StarryClear/LQR_Furuta/VERSION_1.1.md

# VERSION_1.1 · 平衡抖动修复（2026-11-03）

## 一、改了什么

只动 `src/lqr_core.v` 两个常数：

| 项 | 1.0（0x6A6F） | 1.1（0x2D55） |
|---|---|---|
| `KDT`（θ̇ 阻尼，Q8） | 60 | **120** |
| θ̇ 一阶低通 | `>>>3`（8 ms） | **`>>>1`（2 ms）** |

原因：1.0 的 8 ms 低通在 5 Hz 吃 14°、11.4 Hz 吃 33°，把 KDT 的相位超前吃光；KDT 本身又只有设计值的 1/7。结果是 5 Hz、±3° 的极限环。加 KDT、缩低通后 5 Hz 动能从 96% 降到约 3%。

## 二、码流与复验

- 码流：`firmware/LQR_end1.1_0x2D55.fs`，**CheckSum 0x2D55**
- 源码重建校验和 **0x2D55**（与板上逐字节等价，见 `evidence/build_1.1.log`）
- Fmax **50.022 MHz**（约束 50.000）、TNS setup/hold **0/0**、最差 setup slack **+0.009 ns**
- CLS 7550/10368（73%）、DSP 11/24（46%）

重建：

```powershell
cd <仓库根目录>
& '$env:GOWIN_HOME\IDE\bin\gw_sh.exe' build.tcl
```

## 三、实测效果

### 3.1 定版十段实测（2026-11-03 20:20~21:10，板载本版 1.1）

全部原始数据 `docs/data/v30_S*.csv`，每段单独抓包，判据口径见 `docs/03_数据与复算.md`。

| 段 | 内容 | 结果 |
|---|---|---|
| S0 / S0b2 | 连通与静止噪声 | 100.1 Hz 稳定；SA100 静止 ±0.25°（1σ 0.06°，60 s 内 6 个码值） |
| S1 | 起摆单次 | 6.76 s 起 kick、**7.91 s 进平衡**，此后连续 22.1 s |
| S2 | 起摆统计 | **10/10 成功**（11 轮里 1 轮起点过晚剔除），中位 **1.14 s**（1.11~1.16） |
| S3 | 平衡预热 90 s | p50 0.70° / p95 1.80° / rms 0.93° / max 2.70°，主频 **8.22 Hz** |
| S4 | **长跑 660.1 s** | p50 **0.70°** / p95 **1.60°** / rms **0.86°** / max 2.40°；duty 峰值 1161、**饱和 0 帧**；横臂净漂 −21 counts（−9.2°，**0.83 °/min**）；主频 8.03 Hz |
| S6 | 抗瞬时推扰 60 s | 峰值 5.0~14.1°，**8 次推扰 8 次恢复**，恢复 0.19~1.33 s |
| S7b | 跟随阶跃 +18° | 实测 +14.4°、静差 −3.6°、过冲 26° 后回落；θ p50 0.70° / p95 1.60°，与纯平衡同 |
| S9 | 正弦 0.245 Hz / 35° | 实测 ±26.6°（**76%**），θ p95 1.90° |
| S10 | 正弦 0.351 Hz / 50° | 实测 ±33.8°（**68%**），θ p95 3.10° |

两条判废记录（不进任何报告/文档结论）：`v30_S5_discarded.csv`（抓包早于指令，两次推倒）、
`v30_S7.csv`（手碰台面导致掉摆，非跟随所致）。

### 3.2 短测（111 s）与 1.0 的对比

数据：`docs/data/hold_1.1_111s.csv`（111.0 s 连续平衡，截止到第一次掉摆前；统计去掉前 3 s 捕获瞬态）。

| 指标 | 1.0（514.8 s 段） | 1.1（111 s 段） | 1.1（定版 660 s 段） |
|---|---|---|---|
| \|θ\| p50 | 1.70° | **0.70°** | 0.70° |
| \|θ\| p95 | 3.50° | **1.80°** | **1.60°** |
| rms | 2.03° | **≈0.9°** | 0.86° |
| 主频 | 5.1 Hz | **8.1 Hz** | 8.03 Hz |
| 3–7 Hz 能量 | 96% | **0.12°（≈3%）** | — |
| 7–10 Hz | 0.1° | 0.76° | — |
| duty 翻转 | 10.1 次/s | 18.4 次/s | — |
| duty 峰值 | 1850 | 955 | 1161 |

## 四、为什么 8.1 Hz 不再继续压

8.1 Hz 是**结构模态**：同频下编码器只有 0.12°，摆杆 1.0°——电机侧和横臂侧不同步（联轴器/横臂扭转）。

试过 8.4 Hz 二阶陷波：

| 版本 | 主频 | p95 | rms |
|---|---|---|---|
| 陷波 Q=6（0x9CDE） | 6.0 Hz | 2.40° | 1.30° |
| 陷波 Q=10（0xA6F6） | 5.85 Hz | 2.30° | 1.22° |

8.4 Hz 确实压到 0.1° 量级，但**刚体模态（横臂跟着动）顶到 5.85–6.0 Hz，幅值更大**。结论：陷波得不偿失，回退到无陷波。两个陷波码流留在原 `LQR_end/firmware/`。

根治只能靠机械：刚性联轴器、横臂加筋，把结构模态推到 15 Hz 以上。

## 五、回滚

```powershell
& '$env:GOWIN_HOME\Programmer\bin\programmer_cli.exe' `
    --device GW2A-18C --cable "Gowin USB Cable(FT2CH)" --run 2 `
    --fsFile "<仓库根目录>\firmware\history\LQR_end_1.0_0x6A6F.fs"
```

## 六、未决与注意

1. **240 s 记录里的跑飞**（2026-11-03 15:0x）：120 s 后横臂持续单向跑、三次掉摆。11-03 晚的
   十段实测里，纯平衡 **660.1 s 未再复现**（S4），单格跟随也正常（S7b），因此判断那次是
   **进了跟随/正弦且目标连续变化**时的老问题，不是平衡通路的退化；但**机理仍未定位**
   （遥测没有 `phi_tgt` 通道，见 `docs/04_已知问题.md` A-1）。
2. **起摆/抗扰已在 1.1 上重测**：起摆 10/10、抗扰 8/8（见第三节）。1.0 的 83% 与 33/35 是
   历史数据，写报告时两者不要混用。
3. **SA100 滑环死点**：每次重烧后若 `ch0` 的 bit7=1、θ 冻结，手转横臂半圈即可（老问题，未修）。
   11-03 晚 S0b 首测的 θ=−116.9° 冻结即此现象，手拨后恢复（S0b2 通过）。
