StarryClear/LQR_Furuta/docs/03_数据与复算.md

# 03 · 数据文件与复算方法

> 本文定义每个 CSV 的字段、每个判据的口径、以及怎么一条命令把报告里的数字重算一遍。
> **报告里出现的任何实测数字，都应该能在这里找到出处。**

---

## 1. 数据来源与链路

```text
FPGA 100 Hz 遥测（VOFA JustFloat，6 通道，115200）
   → tools/capture_raw.ps1（PowerShell 串口抓包，逐帧落盘）
   → docs/data/*.csv
   → tools/recompute_all.py（复算）/ tools/plot_measured.py（出图）
```

抓包脚本按 JustFloat 帧尾 `00 00 80 7F` 分帧，每帧 28 字节取 6 个 float32。

---

## 2. 文件清单

### 2.1 2026-11-03 定版 campaign（板载 1.1 / 0x2D55，报告 v3.x 全部引这个）

| 文件 | 时长 | 帧数 | 用途 |
|---|---|---|---|
| `v30_S0.csv` | 10 s | 1000 | 连通性：100 Hz、state 全 0、duty 0 |
| `v30_S0b.csv` | 60 s | 6000 | **异常样本**：θ 恒 −116.9°（60 s 只有 1 个码值）、pos 被复位 3245→0 → 判"摆杆被卡住/滑环死点"，修好后才做 S0b2 |
| `v30_S0b2.csv` | 60 s | 6005 | SA100 静止噪声（±0.25°，1σ 0.06°） |
| `v30_S1.csv` | 30 s | 3000 | 起摆全过程：6.76 s kick、7.91 s 入平衡、平衡 22.1 s |
| `v30_S2.csv` | 200 s | 19855 | 起摆统计：11 轮，10 轮可判、10/10 成功，中位 1.14 s |
| `v30_S3.csv` | 90 s | 9002 | 平衡预热：p50 0.70 / p95 1.80 / rms 0.93 / max 2.70 |
| `v30_S4.csv` | 660 s | 66007 | **长跑**：p50 0.70 / p95 1.60 / rms 0.86 / max 2.40、漂移 −21 counts |
| `v30_S6.csv` | 60 s | 6000 | 抗扰：8 次推扰 8 次恢复，峰值 5.0~14.1° |
| `v30_S7b.csv` | 30 s | 3007 | 跟随阶跃 +18°：实测 14.4°、静差 −3.6°、过冲 26° |
| `v30_S9.csv` | 30 s | 3002 | 正弦 NORMAL：0.245 Hz，35° → ±26.6°（76%） |
| `v30_S10.csv` | 30 s | 2999 | 正弦 FAST：0.351 Hz，50° → ±33.8°（68%） |
| `v30_S4_discarded.csv` | — | 21301 | 抓包早于指令，**作废**，不进任何结论 |
| `v30_S5_discarded.csv` | — | — | 同上，作废 |
| `v30_S7.csv` | — | — | 手碰台面导致掉摆，非跟随所致，**作废** |

### 2.2 1.0 历史数据（0x6A6F）

| 文件 | 时长 | 帧数 | 用途 | 对应测试 |
|---|---|---|---|---|
| `hold10min.csv` | 600 s | 60002 | 平衡保持长测 | T3 / T4 |
| `hold10min_b.csv` | 145 s | 14500 | T3 的补测尝试（未满 600 s） | 参考 |
| `hold_1.1_111s.csv` | 111 s | 11100 | 1.1 的首次短测（docs/VERSION_1.1 三节） | 参考 |
| `swing10.csv` | 198 s | 19817 | 起摆 18 次 | T1 / T2 |
| `disturb3.csv` | 120 s | 12004 | 手工推扰 | T5 |

---

## 3. 字段定义

| 列 | 含义 | 单位 | 换算 |
|---|---|---|---|
| `t` | **帧序号**（不是毫秒） | 帧 | 秒 = `t / 100` |
| `theta` | 摆杆倾角 θ | 0.1° | ° = `theta / 10` |
| `duty` | 电机占空比 | counts | 2500 = 100%；限幅 ±2000 |
| `state` | 起摆状态机 `sw_state` | — | 0 停 / 1 kick / 2 反踢 / 3 泵能 / 4 滑行 / 5 平衡 / 6 掉摆 |
| `pos` | 横臂编码器相对计数 | counts | 824.5 counts/圈 → ° = `pos × 0.4366` |
| `ch0` | 原始 ch0 打包值 | — | `state = (ch0>>4)&7`，`sensor_lost = (ch0>>7)&1` |
| `ch5` | 原始 ch5 打包值 | — | `{sw_inv_r, e_dbg[14:0]}`，起摆能量诊断 |

> ⚠ `t` 是**帧序号**不是毫秒。`capture_raw.ps1` 里 `$n` 自增后直接写进第一列，
> 按 100 Hz 换算成秒要 `÷100`。别直接当 ms 用（会差 10 倍）。

---

## 4. 判据口径（统一）

| 量 | 定义 |
|---|---|
| **起摆成功** | 进入 `state=5` 后连续保持 ≥ **2 s**（不是"碰到 state5 就算"） |
| **捕获时间** | `state` 由 1 变为 5 的时间差 |
| **连续平衡段** | `state=5` 的最长连续帧数 ÷ 100 |
| **稳态段** | 最长平衡段**去掉前 5 s**（捕获瞬态） |
| **θ 统计** | 在稳态段上算 p50 / p95 / rms / max，取绝对值 |
| **duty 饱和** | `\|duty\| >= 2000` 的帧 |
| **横臂漂移** | 段内 `pos` 末值 − 首值（净漂）与 `max − min`（峰峰） |
| **一次推扰** | 1.0 口径：`state=5` 内 `\|θ\| >= 8°` 的超阈事件，间隔 < 0.3 s 的合并为一次；<br>1.1 口径（v30_S6）：`\|θ\| >= 4.5°` 起判、**2 s 内合并**——阈值更低是为了不漏掉轻推，合并窗更长是因为 8 Hz 抖动会反复越阈 |
| **回正时间** | 峰值那一帧起，到 `\|θ\|` 连续 0.5 s 都在 2.5° 以内为止 |
| **跟踪率** | 实测幅度 ÷ 设定幅度（正弦段取 θ 的 5%~95% 分位之差的一半） |

---

## 5. 复算

### 5.1 定版 campaign（1.1，v30_S*.csv）

```powershell
# 单段复算（以 S4 长跑为例；脚本读 docs\data\<file>.csv，列 t,ch0,duty,pos,theta,adc,ch5）
python tools\recompute_v30.py S4
```

当前基线输出（与 `python tools\recompute_v30.py S4` 的实际打印逐字一致）：

```text
【S4】66007 帧 / 660.06 s / 100.0 Hz
  sensor_lost 帧           : 0
  state 分布               : {5: 66007}
  最长 state=5 段          : 66007 帧 = 660.1 s（起点 0.00 s）
  |θ| p50 / p95 / rms      : 0.70° / 1.60° / 0.86°
  |θ| max / θ 范围         : 2.40° / -1.80° ~ 2.40°
  duty mean|.| / 峰值       : 421 / 1161（限幅 ±2000）
  duty 饱和帧数             : 0
  横臂净漂 / 峰峰           : -21 counts (-9.2°) / 33 counts
  横臂漂移速率              : 0.83 °/min
  抖动主频（过零估）        : 7.97 Hz
```

> 主频：脚本用"θ 去均值后的过零率"估，S4 得 7.97 Hz；对同一段做 FFT 得 **8.03 Hz**，
> 两者差 <1%。报告统一写 FFT 值，脚本输出有 ±0.1 Hz 的口径差异属正常。
> rms 按**带符号 θ 对 0** 计算（`sqrt(mean(θ²))`），不是对 `|θ|` 的均值算。

其余两段的脚本输出（同样可直接复现）：

```text
【S1】3005 帧 / 30.04 s；state 分布 {0:676, 1:25, 2:25, 3:65, 5:2214}
  最长 state=5 段          : 2214 帧 = 22.1 s（起点 7.91 s）
  |θ| p50 / p95 / rms      : 0.70° / 2.30° / 1.11°
  起 kick / 进平衡          : 6.76 s / 7.91 s（用时 1.15 s）

【S6】6000 帧 / 59.99 s；state 全程 = 5
  duty mean|.| / 峰值       : 437 / 1974（限幅 ±2000）
  推扰事件（|θ|≥4.5°，2 s 合并）: 8 次
  各次峰值                  : 5.1° / 5.8° / 7.1° / 7.5° / 14.1° / 7.1° / 7.1° / 5.0°
```

【S2 起摆统计】可判 10 轮 → 10/10 成功，kick→state5 中位 1.14 s（1.11~1.16）——S2 是 11 轮连续尝试，
脚本按"最长 state=5 段"只能看单轮，成功率需人工按轮切分，见 02 的 T2。

### 5.2 1.0 历史基线

```powershell
cd <工程根目录>          # 脚本按自身位置定位 docs\data，跑到哪儿都行
python tools\recompute_all.py
```

输出应与 [02_测试清单与数据记录.md](02_测试清单与数据记录.md) 的 1.0 历史行一致：

```text
【T1 起摆成功率】
  起摆尝试次数          : 18
  完成捕获（进 state5） : 17  (94%)
  捕获后站住 >=2 s      : 15  (83%)
【T2 起摆耗时】
  kick -> state5        : 中位 1.14 s，范围 1.10~1.77 s

【T3 连续平衡】
  state5 最长连续段     : 51478 帧 = 514.8 s（共 1 段）
【T4 稳态精度】（去掉段首 5 s，50978 帧）
  |θ| p50 / p95 / rms   : 1.70° / 3.50° / 2.03°
  |θ| max（稳态段）     : 4.90°
  |θ| max（含捕获瞬态） : 13.00°
  θ 范围                : -4.9° ~ 4.5°
  duty mean|.| / 峰值   : 508 / 1850（限幅 2000）
  duty 饱和帧数         : 0
  横臂净漂 / 峰峰       : 77 counts (33.6°) / 127 counts (55.5°)  用时 514.8 s
  横臂漂移速率          : 3.92 °/min
  duty 抖振：符号翻转   : 10.1 次/秒；峰峰 3620 counts
  duty 抖振主频（1~30 Hz）: 5.1 Hz

【T5 抗瞬时推扰】
  超阈事件（|θ|≥8°）    : 55 个；按 0.3 s 间隔合并为推扰 35 次
  未掉摆                : 33 次（94%）
  恢复样本峰值角        : 中位 13.4°，最大 26.7°
  掉摆                  : 2 次
```

---

## 6. 出图

```powershell
python tools\plot_measured.py     # 输出 docs\figures\fig1..fig4
```

| 图 | 内容 | 对应 |
|---|---|---|
| `fig1_swingup.png` | 起摆全过程 θ / duty / 状态切换 | T2 |
| `fig2_balance.png` | 514.8 s 平衡段 θ / duty | T3 / T4 |
| `fig3_disturb.png` | 120 s 推扰 θ / duty | T5 |
| `fig4_capture_time.png` | 每次起摆的捕获时间柱状图 | T1 |

> 绘图不依赖 matplotlib（本机没有），用 Pillow 直接画，中文字体取 `C:\Windows\Fonts\msyh.ttc`。

---

## 7. 抓包（补测时用）

```powershell
cd <仓库根目录>\tools\experiments_20261102
.\capture6.ps1 -Port COM8 -Seconds 60 -Out "..\..\docs\data\v30_Sx.csv"
```

> **端口是 COM8**（不是旧文档里的 COM6）。
> `capture6.ps1` 是 2026-11-03 重写过的版本：按 JustFloat 帧尾 `00 00 80 7F` 分帧后，
> 会对 6 个 float 做范围校验（ch0∈[0,4095]、|duty|≤2600、|pos|≤2e6、|θ|≤4000、
> adc∈[−10,6000]、|ch5|≤40000），越界判为**假帧尾**、跳 1 字节重新同步。
>
> 旧脚本 `capture_raw.ps1` 不做校验，帧尾恰好出现在浮点数据时会解出 `-1.38E+19` 之类的假帧，
> 导致 `[int]` 溢出报错、约 0.9% 帧丢失（S2 就丢了一部分）。补测请一律用 `capture6.ps1`。
