StarryClear/LQR_Furuta/docs/figures/fig1_swingup.png

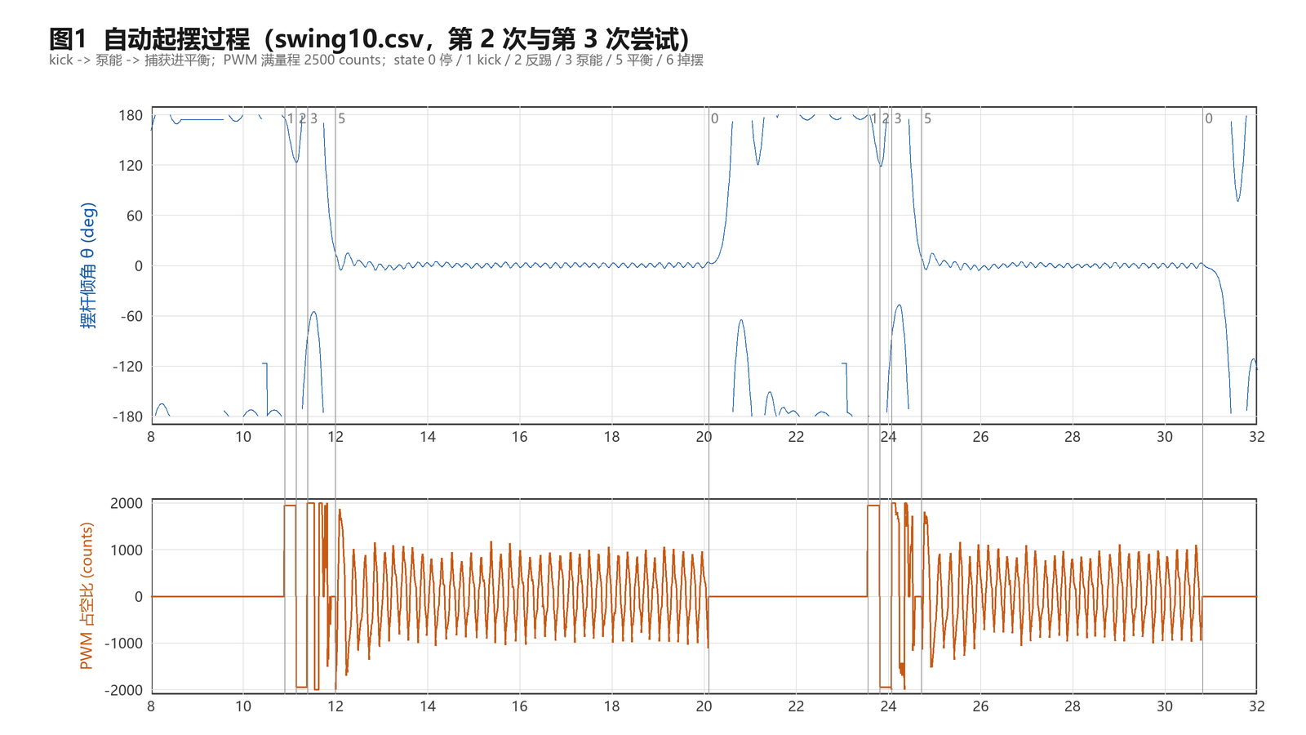
docs/figures/fig1_swingup.png
