StarryClear/LQR_Furuta/docs/figures/fig3_disturb.png

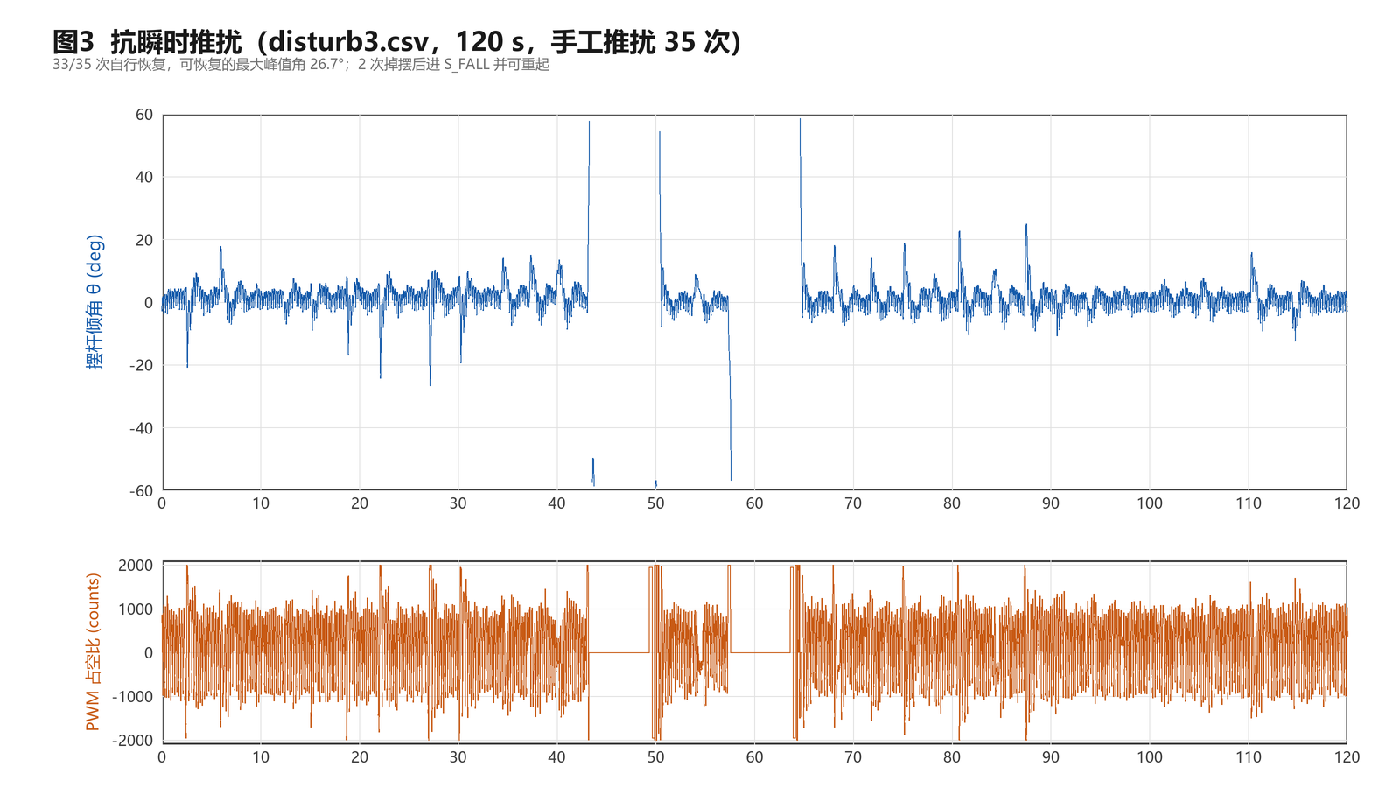
docs/figures/fig3_disturb.png
