StarryClear/LQR_Furuta/docs/figures/fig4_capture_time.png

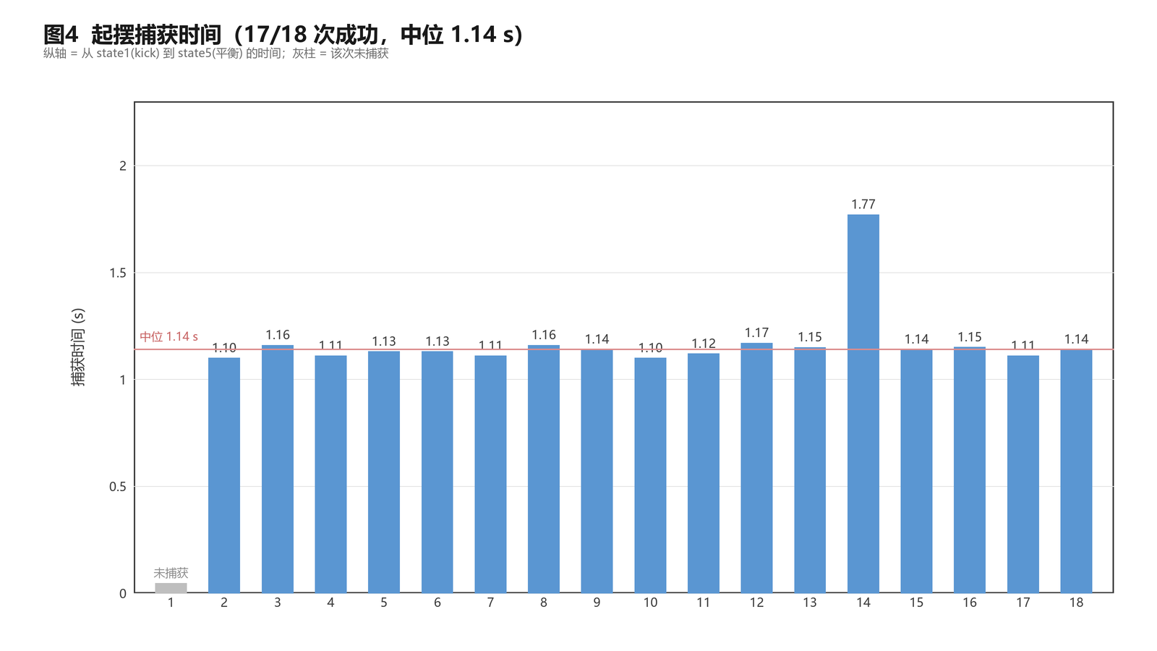
docs/figures/fig4_capture_time.png
