StarryClear/LQR_Furuta/docs/02_测试清单与数据记录.md

# 02 · 测试清单与数据记录（LQR_end 定版）

> 逐项测量 → 就地记录 → 报告直接引用。每项写明**测法、判据、原始数据文件、复算命令**。
> 所有数字都能复算：1.0 基线用 `python tools/recompute_all.py`，定版 campaign 用
> `python tools/recompute_v30.py all`；对不上就是文档与数据脱节了。
>
> 数据目录：`docs/data/`　图：`docs/figures/`　证据：`evidence/`

---

## 0. 记录约定

| 符号 | 含义 |
|---|---|
| ✅ | 已测，数据在 `docs/data/` |
| ⬜ | 未测 |
| 🅿️ | 只是静态参数，从综合报告读出 |
| 判据 | 赛题原文要求 或 工程自定目标 |

**统一口径**：遥测 100 Hz；θ 单位 0.1°（记录时换 °）；duty 单位 counts（2500 = 100%）；pos 单位编码器计数（824.5 counts/圈 ≈ 0.4366°/count）。

---

## 1. 赛题要求对照总表

| 赛题条目 | 要求 | 本工程状态（2026-11-03 定版实测） | 判定 |
|---|---|---|---|
| 基础 ① | 起摆：静止下垂的摆杆被抬起，最终停在垂直位置附近 | **10/10 成功**，kick→平衡 中位 1.14 s（`v30_S2`） | ✅ |
| 基础 ② | 自平衡：长时间稳定保持在垂直平衡位置 | 单段 **660.1 s** 不倒（`v30_S4`） | ✅ |
| 基础 ③ | 平衡后无明显震荡；能抗轻微外力并短时间恢复 | \|θ\| p95 **1.60°**；推扰 **8/8 恢复**，可恢复峰值 14.1°（`v30_S4`/`v30_S6`） | ✅ |
| 拓展 ① | 键盘/拨码设定目标位置，电机平滑移动并保持静止 | 旋钮 + OLED，每格 18°；**实测 +18° → +14.4°，静差 −3.6°**（`v30_S7b`） | ✅ |
| 拓展 ② | 电机按特定速度曲线/轨迹运动，同时保持摆杆不倒 | 正弦 **0.245 Hz 跟踪 76% / 0.351 Hz 68%**，全程不倒（`v30_S9`/`v30_S10`） | ✅ |
| 拓展 ③ | 位置控制过程中摆杆始终直立 | 单格阶跃能保持直立；**大目标阶跃仍会掉摆**（未实测阈值已写入 04） | ⚠ |

> 拓展①②已有实测；拓展③只测到"单格 18° 不掉"，更大阶跃没有再测（会掉，见 04 已知问题 A-1）。

---

## 2. 基础要求

### T1 起摆成功率 ✅

- **测法**：F10 复位 → 等 1 s → 按 D11，重复 N 次；判"成功"为捕获后站住 ≥ 2 s
- **判据**：成功率 ≥ 90%
- **数据**：`docs/data/v30_S2.csv`（1.1 定版，200 s）、`docs/data/swing10.csv`（1.0，198 s）
- **实测（1.1，2026-11-03）**：

| 指标 | 数值 |
|---|---|
| 起摆尝试 | **11** 轮（第 11 轮起点过晚、数据不足，剔除） |
| 可判轮数 | 10 |
| **捕获后站住 ≥2 s** | **10 / 10 = 100%** |
| 捕获时间 | 中位 **1.14 s**，范围 1.11 ~ 1.16 s |

- **1.0 历史**：18 次尝试、17 次捕获（94%）、15 次站住（83%）；3 次失败均伴随 SA100 坏点。
- **图**：[fig4_capture_time.png](figures/fig4_capture_time.png)（1.0 数据）

### T2 起摆时间分解 ✅

- **判据**：起摆全过程 ≤ 3 s
- **实测**（读 state 机时间戳）：

| 阶段 | 耗时 |
|---|---|
| kick（state 1） | ≈ 250 ms |
| 反踢（state 2） | ≈ 250 ms |
| 泵能（state 3） | ≈ 550 ms |
| **kick → 捕获（state 5）** | **1.14 s（中位）** |

- **1.1 单次全过程**（`docs/data/v30_S1.csv`）：0 s 静止 → **6.76 s** 起 kick → 7.01 / 7.26 s 过 state 2/3
  → **7.91 s 进 state 5** → 此后连续平衡 22.1 s（到 30 s 抓包结束）。
- **结论**：远优于 3 s 判据；10 次成功样本全部落在 1.11~1.16 s，重复性很好。
- **图**：[fig1_swingup.png](figures/fig1_swingup.png)（1.0 数据）

### T3 平衡保持时长 ✅

- **测法**：起摆入稳后不接触，连续抓包 660 s，统计 `state=5` 的最长连续段
- **判据**：≥ 10 分钟（600 s）
- **数据**：`docs/data/v30_S4.csv`（660.07 s，66007 帧，20:38:54~20:49:54）
- **实测**：

| 指标 | 数值 |
|---|---|
| 最长连续平衡段 | **66007 帧 = 660.1 s**（11 分 00 秒） |
| 闭环段数 | 1 段（全程 state=5，无掉摆、无重摆） |
| 口径说明 | 抓包起点已在平衡态，故结论写作"**连续平衡 ≥ 660 s**"，不是"从起摆算起 660 s" |
| 1.0 历史 | 514.8 s（抓包比起摆早开约 85 s，故未满 600 s） |

### T4 平衡稳态精度 ✅

- **测法**：取 T3 最长闭环段全程统计（1.1 段首已在平衡态，无捕获瞬态需剔除）
- **判据**：\|θ\| p95 ≤ 3°；横臂漂移 ≤ ±15°
- **实测**（66007 帧）：

| 指标 | 1.1（660.1 s） | 1.0（514.8 s，历史） |
|---|---|---|
| \|θ\| p50 | **0.70°** | 1.70° |
| \|θ\| p95 | **1.60°** | 3.50° |
| \|θ\| rms | 0.86° | 2.03° |
| \|θ\| max | **2.40°**（范围 −1.80° ~ +2.40°） | 4.90°（含瞬态 13.0°） |
| duty mean\|.\| | 421（满量程 2500 的 17%） | 508 |
| duty 峰值 | **1161**（限幅 2000） | 1850 |
| **duty 饱和帧数** | **0** | 0 |
| 横臂净漂 | **−21 counts / −9.2°** | 77 counts / 33.6° |
| 横臂峰峰 | 33 counts | 127 counts |
| 横臂漂移速率 | **0.83 °/min** | 3.92 °/min |
| 抖动主频 | 8.03 Hz | 5.1 Hz |

- **结论**：θ 指标满足判据；横臂漂移由 3.9 °/min 降到 **0.83 °/min**（外环积分起效），11 分钟漂 9.2°，
  仍在"±15°"口径内。属外环无位置反馈的固有慢漂。
- **图**：[fig2_balance.png](figures/fig2_balance.png)（1.0 数据）

### T5 抗瞬时推扰 ✅

- **测法**：平衡中手工瞬时推扰，抓包 60 s
- **数据**：`docs/data/v30_S6.csv`（1.1 定版，60 s）、`docs/data/disturb3.csv`（1.0，120 s）
- **判据**：轻微/中等推扰能恢复且不倒
- **实测（1.1，复算口径：state5 内 \|θ\|≥4.5° 起判，2 s 内合并为一次推扰）**：

| 指标 | 数值 |
|---|---|
| 检出推扰 | **8** 次 |
| 未掉摆（恢复） | **8 次（100%）** |
| 各次峰值角 | 5.1° / 5.8° / 7.1° / 7.5° / **14.1°** / 7.1° / 7.1° / 5.0° |
| 恢复时间 | 0.19 ~ 1.33 s（回到 ±5° 内） |
| 单次推扰 duty 峰值 | 1974（99% 限幅），全程饱和 0 帧 |
| 横臂位移 | 净 −10 counts，峰峰 218 counts（≈95°，无位置环不自回） |

- **1.0 历史**：120 s 内 35 次推扰、33 次恢复（94%），可恢复峰值 26.7°。
- **说明（报告必须保留）**：推扰由人手施加，**力度不可标定**，因此以"实测摆杆峰值角"作为强度度量，
  而不是标称力/角度。
- **图**：[fig3_disturb.png](figures/fig3_disturb.png)（1.0 数据）

---

## 3. 拓展要求（当前空白）

> 这三项是赛题拓展分，**固件已经能跑，缺的只是抓包**。每项约 20~30 分钟。

### T6 跟随定位精度 ✅（单格已实测）

- **测法**：平衡后进轨迹页选"跟随"，旋钮转过一格（每格 18°），记录实际位移与收敛过程
- **判据**：单格位移误差 ≤ 3°；无明显持续振荡
- **数据**：`docs/data/v30_S7b.csv`（30.06 s，全程 state=5）
- **实测（FAST 档，目标 +18°）**：

| 指标 | 数值 |
|---|---|
| 目标角 | +18° |
| 稳态实测 | **+14.4°**（+33 counts） |
| 稳态误差 | **−3.6°** |
| 过程过冲 | 26°（59 counts），随后回落 |
| 收敛 | 约 1 s 内稳住 |
| 摆杆 \|θ\| p50 / p95 | 0.70° / **1.60°**（与纯平衡同，跟随未牺牲姿态） |
| duty 饱和 | 0 帧 |

- **结论**：单格阶跃能站住，但**静差 3.6° 超出 3° 判据**——外环无积分作用于 φ 目标（积分作用在绝对 θ），
  属结构性问题，见 [04_已知问题.md](04_已知问题.md) B-2。
- **未测**：其余三档速度、连续多格（3 格 = 54°）—— 大目标阶跃会掉摆，先不写进结论。

### T7 正弦轨迹 ✅（两档已实测）

- **测法**：轨迹页选正弦档，速度档选 NORMAL / FAST，各跑 30 s
- **判据**：摆杆 \|θ\| p95 ≤ 8°、不倒下
- **数据**：`docs/data/v30_S9.csv`（NORMAL）、`docs/data/v30_S10.csv`（FAST）
- **实测**：

| 速度档 | 频率（实测） | 幅度设定 | 实测幅度 | 跟踪率 | 摆杆 p95 | 是否倒 |
|---|---|---|---|---|---|---|
| NORMAL（屏显 60 °/s） | **0.245 Hz**（周期 4.084 s） | 35° | **±26.6°** | **76%** | 1.90° | 否 |
| FAST（屏显 90 °/s） | **0.351 Hz**（周期 2.848 s） | 50° | **±33.8°** | **68%** | 3.10° | 否 |

- **结论**：频率升高、跟踪率下降（76% → 68%），是位置环带宽不足的**干净低通特性**；
  两档全程 state=5、duty 无饱和。摆杆 p95 3.10° 说明 FAST 档姿态代价可用。
- **档位映射（重要）**：`bal_top.v:879-884` 的 `sin_step` = 10/16/23/33 → 0.15/0.25/0.35/0.50 Hz（4 档），
  实测频率与 `sin_step` 逐位吻合；OLED SPEED 页显示的是 **30/60/90/120 °/s**，与 `follow_slew` 注释里的
  10/20/50/100 不一致，见 [04_已知问题.md](04_已知问题.md) C-1。

### T8 速度档位实测 ⬜

- **测法**：同 T6，用横臂运动段的速度中位数衡量
- **屏显标称**：SLOW 30 / NORMAL 60 / FAST 90 / TURBO 120 °/s（`follow_slew` 注释写的是 10/20/50/100，不一致）
- **记录**：SLOW ___、NORMAL ___、FAST ___、TURBO ___ °/s（**未测**）

---

## 4. 静态参数（从综合/约束文件读出，可直接引用）

### T9 控制与采样参数 🅿️

| 项 | 值 |
|---|---|
| 系统时钟 | 50 MHz |
| 姿态控制周期 | 1 ms（1 kHz） |
| SA100 角度帧率 | ≈ 856 Hz（PWM 占空比解码） |
| 角度分辨率 | 0.1°（原始 12 位 / 360° = 0.0879°/count） |
| 编码器分辨率 | 824.5 counts/圈 ≈ 0.4366°/count（四倍频） |
| 测速更新 | 10 ms 差分 + 一阶低通（τ≈40 ms） |
| θ̇ 估计 | 4 ms 差分 + 一阶低通（1.1 为 **2 ms**，1.0 为 8 ms） |
| PWM 频率 | 20 kHz（2500 counts 满量程，分辨率 0.04%） |
| 电流采样 | 20 kHz（MCP3201，SPI） |
| 遥测 | VOFA JustFloat，6 通道 @100 Hz，115200（占用 24% 带宽） |

### T10 资源占用 🅿️

| 资源 | 用量 | 占比 |
|---|---|---|
| Logic | 13081 / 20736 | 64% |
| LUT | 7780 | — |
| Register | 3644 / 16173 | 23% |
| **CLS** | **7550 / 10368** | **73%** |
| BSRAM | 18 / 46 | 40% |
| DSP | 11 / 24 | 46% |
| I/O | 27 / 207 | 14% |

**按模块**（`evidence/resource_by_module.xml`）：

| 模块 | LUT（含子模块） | 说明 |
|---|---|---|
| `u_menu` | 1758 | OLED 主菜单（含一份 sh1106_i2c + 帧缓冲） |
| `u_oled` | 1467 | OLED 仪表盘（第三份驱动） |
| `u_speed` | 669 | OLED 速度页（第二份驱动） |
| `u_swing` | 605 | 起摆状态机 |
| `u_vofa` | 593 | 遥测（纯组合 float 转换） |
| `u_lqr` | 361 | LQR 内核 |
| `u_pwm` / `u_ang` | 213 / 170 | 角度捕获与解码 |

> **UI 三件套合计约 3957 LUT ≈ 全设计 51%**；控制部分（起摆+LQR+角度+测速）约 1500 LUT ≈ 19%。

### T11 时序 🅿️

| 项 | 1.1（0x2D55，定版） | 1.0（0x6A6F，历史） |
|---|---|---|
| 约束 | 50 MHz | 50 MHz |
| 实际 Fmax | **50.022 MHz** | 50.008 MHz |
| TNS | setup 0.000 / hold 0.000 | 同 |
| 违例端点 | 0 | 0 |
| 最差路径 slack | **+0.009 ns** | +0.003 ns |
| 最差路径 | `u_menu/r_anim_0_s0/Q → u_menu/frm_frm_4_1_s0/DI[3]` | 同 |
| 码流 | `firmware/LQR_end1.1_0x2D55.fs`，CheckSum `0x2D55` | `firmware/history/LQR_end_1.0_0x6A6F.fs` |

---

## 5. 鲁棒性

### T12 传感器野值统计 ⬜

- **测法**：抓 60 s，统计 `angle_calc` 被判野值（跳变 >40 counts）的帧比例
- **判据**：≤ 1%
- **阻塞**：`rej_cnt` 没有进遥测，当前无法统计；需扩遥测通道（见 [04_已知问题.md](04_已知问题.md)）
- **历史参考**：改前 5.4%，加中值+门限后 0.29%（LQR_3.0 阶段，非本定版）

### T13 长时运行稳定性 ⬜

- **测法**：连续运行 30 min（可叠在 T3 上）
- **记录**：掉摆次数 ___；恢复成功 ___；Fmax 是否变化 ___
- **现有**：单段 **660.1 s（11 分 00 秒）已记录且全程 state=5、0 次掉摆**（`v30_S4.csv`，
  见 T3）；30 min 未做，仍是空白

---

## 6. 已知限制（写报告的"限制说明"章节）

1. **跟随单格有 3.6° 静差**（目标 18° 得 14.4°），大目标阶跃仍会掉摆（拓展③只做了一半）
2. **横臂 0.83°/min 慢漂**（11 min 漂 9.2°），外环无位置反馈，属固有特性
3. **稳态 duty 8.0 Hz 抖振**（峰峰约 2300 counts），电机持续换向（1.1 相比 1.0 幅值腰斩、频率抬高）
4. **SA100 有随机坏点**，靠 3 点中值 + 4°/帧 门限 + 4 帧强制重同步兜住
5. **上电后需转动横臂唤醒**：SA100 在滑环死点无输出
6. **时序余量 9 ps**，没有改版空间
7. **速度档三处不一致**：OLED 屏显 30/60/90/120、`follow_slew` 注释 10/20/50/100、`sin_step` 4 档频率

详见 [04_已知问题.md](04_已知问题.md)。

---

## 7. 复算

```powershell
cd <仓库根目录>
python tools/recompute_all.py        # 1.0 基线（hold10min / swing10 / disturb3）
python tools/recompute_v30.py all    # 定版 campaign（v30_S*.csv），本文第 1~5 节引的定版数字
python tools/plot_measured.py        # 重画 docs/figures/
```

字段定义与判据口径见 [03_数据与复算.md](03_数据与复算.md)。
