StarryClear/LQR_Furuta/tools/experiments_20261102/dist_logs/raw.csv

t | theta | duty | state
0 | 16 | -226 | 5
1 | 12 | -239 | 5
2 | 5 | -228 | 5
3 | 0 | 353 | 5
4 | -6 | 430 | 5
5 | -10 | 482 | 5
6 | -15 | 728 | 5
7 | -12 | 486 | 5
8 | -8 | 237 | 5
9 | -3 | 147 | 5
10 | 3 | -182 | 5
11 | 8 | -204 | 5
12 | 13 | -313 | 5
13 | 16 | -516 | 5
14 | 20 | -563 | 5
15 | 19 | -480 | 5
16 | 15 | -319 | 5
17 | 11 | -369 | 5
18 | 7 | -210 | 5
19 | 3 | 177 | 5
20 | -2 | 236 | 5
21 | -8 | 451 | 5
22 | -13 | 467 | 5
23 | -12 | 383 | 5
24 | -3 | -226 | 5
25 | 4 | -631 | 5
26 | 11 | -835 | 5
27 | 17 | -1052 | 5
28 | 18 | -1111 | 5
29 | 14 | -831 | 5
30 | 10 | -1051 | 5
31 | 6 | -874 | 5
32 | -3 | -696 | 5
33 | -13 | -657 | 5
34 | -23 | -454 | 5
35 | -36 | 123 | 5
36 | -51 | 305 | 5
37 | -62 | 411 | 5
38 | -79 | 831 | 5
39 | -80 | 523 | 5
40 | -77 | 427 | 5
41 | -80 | 539 | 5
42 | -74 | 258 | 5
43 | -71 | 260 | 5
44 | -66 | 196 | 5
45 | -59 | -270 | 5
46 | -51 | -464 | 5
47 | -43 | -606 | 5
48 | -35 | -776 | 5
49 | -32 | -970 | 5
50 | -37 | -497 | 5
51 | -42 | -396 | 5
52 | -47 | -365 | 5
53 | -52 | -302 | 5
54 | -59 | 181 | 5
55 | -66 | 346 | 5
56 | -76 | 374 | 5
57 | -87 | 737 | 5
58 | -95 | 1084 | 5
59 | -95 | 723 | 5
60 | -92 | 696 | 5
61 | -88 | 489 | 5
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
