StarryClear/LQR_Furuta/tools/experiments_20261102/dist_logs/raw31.csv

t | theta | duty | state
0 | 1548 | 0 | 0
1 | 1548 | 0 | 0
2 | 1548 | 0 | 0
3 | 1548 | 0 | 0
4 | 1548 | 0 | 0
5 | 1548 | 0 | 0
6 | 1548 | 0 | 0
7 | 1548 | 0 | 0
8 | 1548 | 0 | 0
9 | 1548 | 0 | 0
10 | 1548 | 0 | 0
11 | 1548 | 0 | 0
12 | 1548 | 0 | 0
13 | 1548 | 0 | 0
14 | 1548 | 0 | 0
15 | 1548 | 0 | 0
16 | 1548 | 0 | 0
17 | 1548 | 0 | 0
18 | 1548 | 0 | 0
19 | 1548 | 0 | 0
20 | 1548 | 0 | 0
21 | 1548 | 0 | 0
22 | 1548 | 0 | 0
23 | 1548 | 0 | 0
24 | 1548 | 0 | 0
25 | 1548 | 0 | 0
26 | 1548 | 0 | 0
27 | 1548 | 0 | 0
28 | 1548 | 0 | 0
29 | 1548 | 0 | 0
30 | 1548 | 0 | 0
31 | 1548 | 0 | 0
32 | 1548 | 0 | 0
33 | 1548 | 0 | 0
34 | 1548 | 0 | 0
35 | 1548 | 0 | 0
36 | 1548 | 0 | 0
37 | 1548 | 0 | 0
38 | 1548 | 0 | 0
39 | 1548 | 0 | 0
40 | 1548 | 0 | 0
41 | 1548 | 0 | 0
42 | 1548 | 0 | 0
43 | 1548 | 0 | 0
44 | 1548 | 0 | 0
45 | 1548 | 0 | 0
46 | 1548 | 0 | 0
47 | 1548 | 0 | 0
48 | 1548 | 0 | 0
49 | 1548 | 0 | 0
50 | 1548 | 0 | 0
51 | 1548 | 0 | 0
52 | 1548 | 0 | 0
53 | 1548 | 0 | 0
54 | 1548 | 0 | 0
55 | 1548 | 0 | 0
56 | 1548 | 0 | 0
57 | 1548 | 0 | 0
58 | 1548 | 0 | 0
59 | 1548 | 0 | 0
60 | 1548 | 0 | 0
61 | 1548 | 0 | 0
62 | 1548 | 0 | 0
63 | 1548 | 0 | 0
64 | 1548 | 0 | 0
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
