StarryClear/LQR_Furuta/tools/experiments_20261102/dist_logs/raw34.csv

t | theta | duty | state
0 | -1738 | 0 | 0
1 | -1727 | 0 | 0
2 | -1715 | 0 | 0
3 | -1706 | 0 | 0
4 | -1697 | 0 | 0
5 | -1692 | 0 | 0
6 | -1685 | 0 | 0
7 | -1680 | 0 | 0
8 | -1677 | 0 | 0
9 | -1676 | 0 | 0
10 | -1675 | 0 | 0
11 | -1676 | 0 | 0
12 | -1680 | 0 | 0
13 | -1683 | 0 | 0
14 | -1686 | 0 | 0
15 | -1691 | 0 | 0
16 | -1698 | 0 | 0
17 | -1703 | 0 | 0
18 | -1712 | 0 | 0
19 | -1720 | 0 | 0
20 | -1728 | 0 | 0
21 | -1736 | 0 | 0
22 | -1745 | 0 | 0
23 | -1753 | 0 | 0
24 | -1761 | 0 | 0
25 | -1769 | 0 | 0
26 | -1780 | 0 | 0
27 | -1789 | 0 | 0
28 | -1800 | 0 | 0
29 | 1792 | 0 | 0
30 | 1782 | 0 | 0
31 | 1774 | 0 | 0
32 | 1764 | 0 | 0
33 | 1756 | 0 | 0
34 | 1748 | 0 | 0
35 | 1740 | 0 | 0
36 | 1734 | 0 | 0
37 | 1729 | 0 | 0
38 | 1723 | 0 | 0
39 | 1719 | 0 | 0
40 | 1717 | 0 | 0
41 | 1714 | 0 | 0
42 | 1712 | 0 | 0
43 | 1712 | 0 | 0
44 | 1714 | 0 | 0
45 | 1716 | 0 | 0
46 | 1718 | 0 | 0
47 | 1722 | 0 | 0
48 | 1727 | 0 | 0
49 | 1732 | 0 | 0
50 | 1738 | 0 | 0
51 | 1745 | 0 | 0
52 | 1750 | 0 | 0
53 | 1756 | 0 | 0
54 | 1761 | 0 | 0
55 | 1766 | 0 | 0
56 | 1772 | 0 | 0
57 | 1778 | 0 | 0
58 | 1785 | 0 | 0
59 | 1790 | 0 | 0
60 | 1794 | 0 | 0
61 | -1785 | 0 | 0
62 | -1761 | 0 | 0
63 | -1736 | 0 | 0
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
