StarryClear/LQR_Furuta/tools/experiments_20261102/dist_logs/raw35.csv

t | theta | duty | state
0 | -1169 | 0 | 0
1 | -1169 | 0 | 0
2 | -1169 | 0 | 0
3 | -1169 | 0 | 0
4 | -1169 | 0 | 0
5 | -1169 | 0 | 0
6 | -1169 | 0 | 0
7 | -1169 | 0 | 0
8 | -1169 | 0 | 0
9 | -1169 | 0 | 0
10 | -1169 | 0 | 0
11 | -1169 | 0 | 0
12 | -1169 | 0 | 0
13 | -1169 | 0 | 0
14 | -1169 | 0 | 0
15 | -1169 | 0 | 0
16 | -1169 | 0 | 0
17 | -1169 | 0 | 0
18 | -1169 | 0 | 0
19 | -1169 | 0 | 0
20 | -1169 | 0 | 0
21 | -1169 | 0 | 0
22 | -1169 | 0 | 0
23 | -1169 | 0 | 0
24 | -1169 | 0 | 0
25 | -1169 | 0 | 0
26 | -1169 | 0 | 0
27 | -1169 | 0 | 0
28 | -1169 | 0 | 0
29 | -1169 | 0 | 0
30 | -1169 | 0 | 0
31 | -1169 | 0 | 0
32 | -1169 | 0 | 0
33 | -1169 | 0 | 0
34 | -1169 | 0 | 0
35 | -1169 | 0 | 0
36 | -1169 | 0 | 0
37 | -1169 | 0 | 0
38 | -1169 | 0 | 0
39 | -1169 | 0 | 0
40 | -1169 | 0 | 0
41 | -1169 | 0 | 0
42 | -1169 | 0 | 0
43 | -1169 | 0 | 0
44 | -1169 | 0 | 0
45 | -1169 | 0 | 0
46 | -1169 | 0 | 0
47 | -1169 | 0 | 0
48 | -1169 | 0 | 0
49 | -1169 | 0 | 0
50 | -1169 | 0 | 0
51 | -1169 | 0 | 0
52 | -1169 | 0 | 0
53 | -1169 | 0 | 0
54 | -1169 | 0 | 0
55 | -1169 | 0 | 0
56 | -1169 | 0 | 0
57 | -1169 | 0 | 0
58 | -1169 | 0 | 0
59 | -1169 | 0 | 0
60 | -1169 | 0 | 0
61 | -1169 | 0 | 0
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
