StarryClear/LQR_Furuta/tools/experiments_20261102/dist_logs/raw36.csv

t | theta | duty | state
0 | -1104 | 0 | 0
1 | -1104 | 0 | 0
2 | -1104 | 0 | 0
3 | -1104 | 0 | 0
4 | -1104 | 0 | 0
5 | -1104 | 0 | 0
6 | -1104 | 0 | 0
7 | -1104 | 0 | 0
8 | -1104 | 0 | 0
9 | -1104 | 0 | 0
10 | -1104 | 0 | 0
11 | -1104 | 0 | 0
12 | -1104 | 0 | 0
13 | -1104 | 0 | 0
14 | -1104 | 0 | 0
15 | -1104 | 0 | 0
16 | -1104 | 0 | 0
17 | -1104 | 0 | 0
18 | -1104 | 0 | 0
19 | -1104 | 0 | 0
20 | -1104 | 0 | 0
21 | -1104 | 0 | 0
22 | -1104 | 0 | 0
23 | -1104 | 0 | 0
24 | -1104 | 0 | 0
25 | -1104 | 0 | 0
26 | -1104 | 0 | 0
27 | -1104 | 0 | 0
28 | -1104 | 0 | 0
29 | -1104 | 0 | 0
30 | -1104 | 0 | 0
31 | -1104 | 0 | 0
32 | -1104 | 0 | 0
33 | -1104 | 0 | 0
34 | -1104 | 0 | 0
35 | -1104 | 0 | 0
36 | -1104 | 0 | 0
37 | -1104 | 0 | 0
38 | -1104 | 0 | 0
39 | -1104 | 0 | 0
40 | -1104 | 0 | 0
41 | -1104 | 0 | 0
42 | -1104 | 0 | 0
43 | -1104 | 0 | 0
44 | -1104 | 0 | 0
45 | -1104 | 0 | 0
46 | -1104 | 0 | 0
47 | -1104 | 0 | 0
48 | -1104 | 0 | 0
49 | -1104 | 0 | 0
50 | -1104 | 0 | 0
51 | -1104 | 0 | 0
52 | -1104 | 0 | 0
53 | -1104 | 0 | 0
54 | -1104 | 0 | 0
55 | -1104 | 0 | 0
56 | -1104 | 0 | 0
57 | -1104 | 0 | 0
58 | -1104 | 0 | 0
59 | -1104 | 0 | 0
60 | -1104 | 0 | 0
61 | -1104 | 0 | 0
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
