StarryClear/LQR_Furuta/tools/history_scripts/README.md

# 历史补丁脚本（不参与构建，仅供追溯）

这两个脚本是 2026-11-02 把 LQR_1.0 的 al_top.v 改造成 LQR_2.1（起摆 + LQR）时用的
**一次性文本替换脚本**。

⚠ 它们里面的路径写死在 D:\DeepSeek_Harness\对话文件\work\LQR_2.1_swing\，
**现在跑不了，也不要跑** —— 保留的原因只有一个：万一需要追溯 2.1 当初到底改了哪几段。

当前工程的 RTL 以 src/ 为准，历史版本以 LQR_11.0/firmware/ 下的码流为准。
