StarryClear/LQR_Furuta/(commit log)

2026-11-03 LQR_Furuta v1.1: GW2A-18 上的旋转倒立摆（全 RTL，无 MCU）
    - 36 个 Verilog（5465 行）：SA100 PWM 解码、编码器四倍频、1 kHz 定点 LQR、
    能量泵起摆状态机、20 kHz PWM、OLED 三页菜单、VOFA 遥测
    - v1.1 码流 CheckSum 0x2D55，源码可完整重建；附 1.0 历史码流用于回滚
    - 实测原始 CSV（起摆 83%、单段平衡 514.8 s、抗扰 33/35）与一键复算脚本
    - 文档记录已知缺陷与未验证结论（docs/04）
    [disturb3.csv, hold10min.csv, hold10min_b.csv, hold_1.1_111s.csv, raw.csv, raw31.csv, raw33.csv, raw34.csv]
2026-11-03 data: 补齐 1.1 定版 campaign 原始数据（v30_S0~S10）与 recompute_v30.py
    [v30_S0.csv, v30_S0b.csv, v30_S0b2.csv, v30_S1.csv, v30_S10.csv, v30_S2.csv, v30_S3.csv, v30_S4.csv]
2026-11-03 docs: 全库切到定版 660.1 s 口径，并加入 20 页技术报告 PDF
